Br0wserz/la-nostra-casa-domotica/13592215_1139793016043733_2497820112202641758_n.jpg

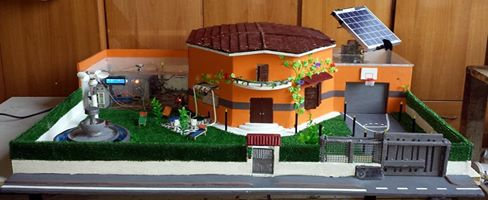
13592215_1139793016043733_2497820112202641758_n.jpg
