Br0wserz/la-nostra-casa-domotica/schemi/controllo-luci-giardino.png

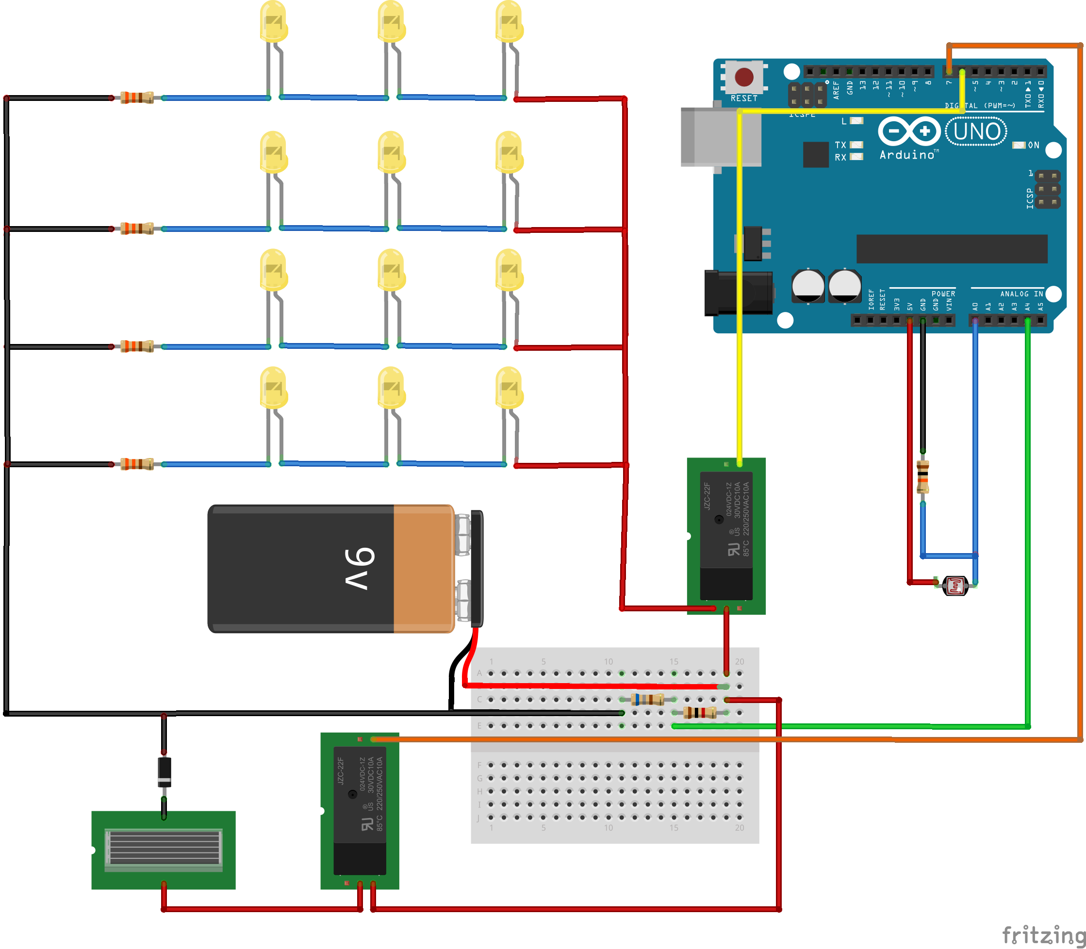
schemi/controllo-luci-giardino.png
