Br0wserz/la-nostra-casa-domotica/schemi/inseguitore_bb.png

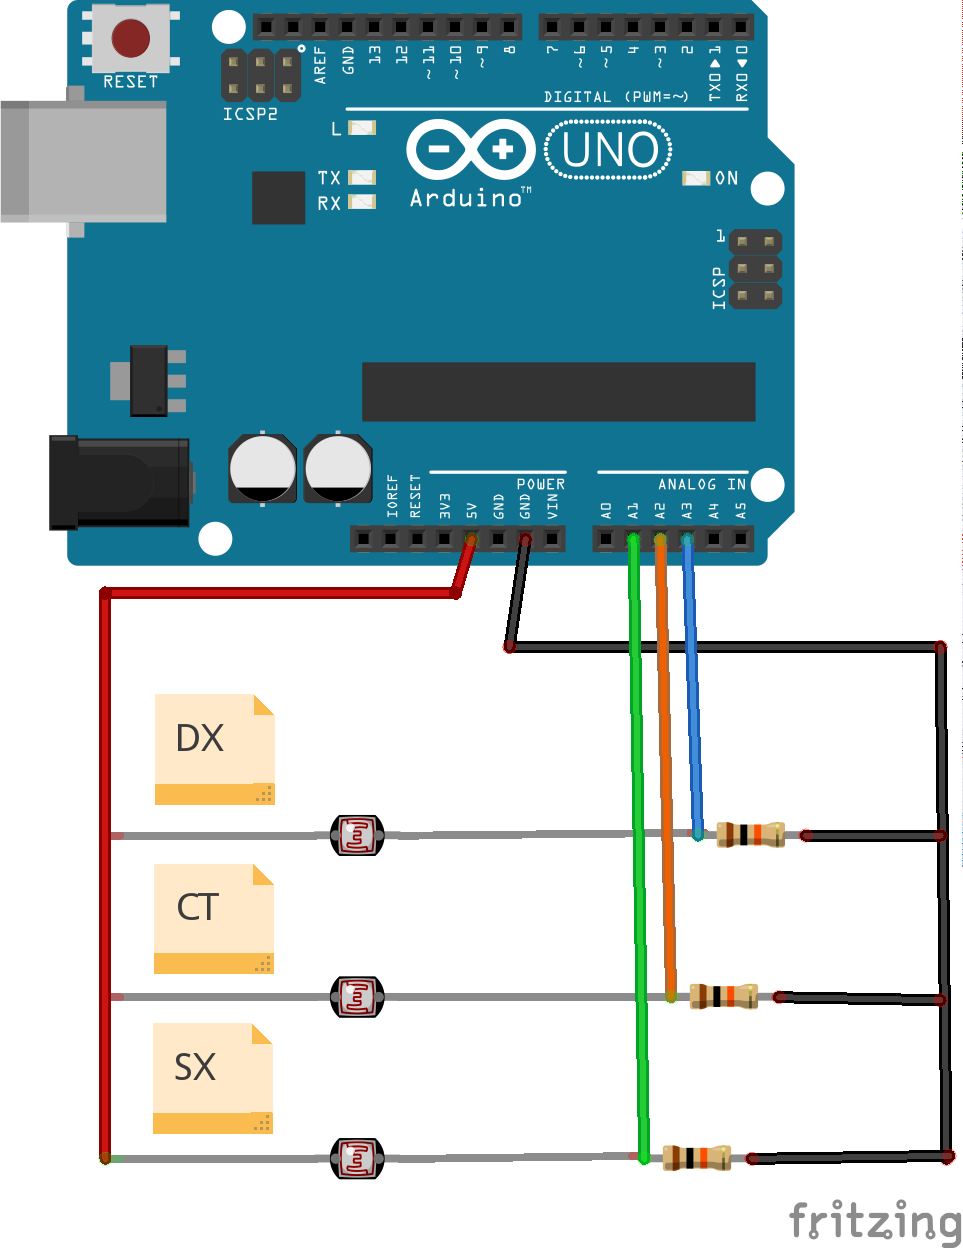
schemi/inseguitore_bb.png
