Br0wserz/la-nostra-casa-domotica/schemi/schema-motori.png

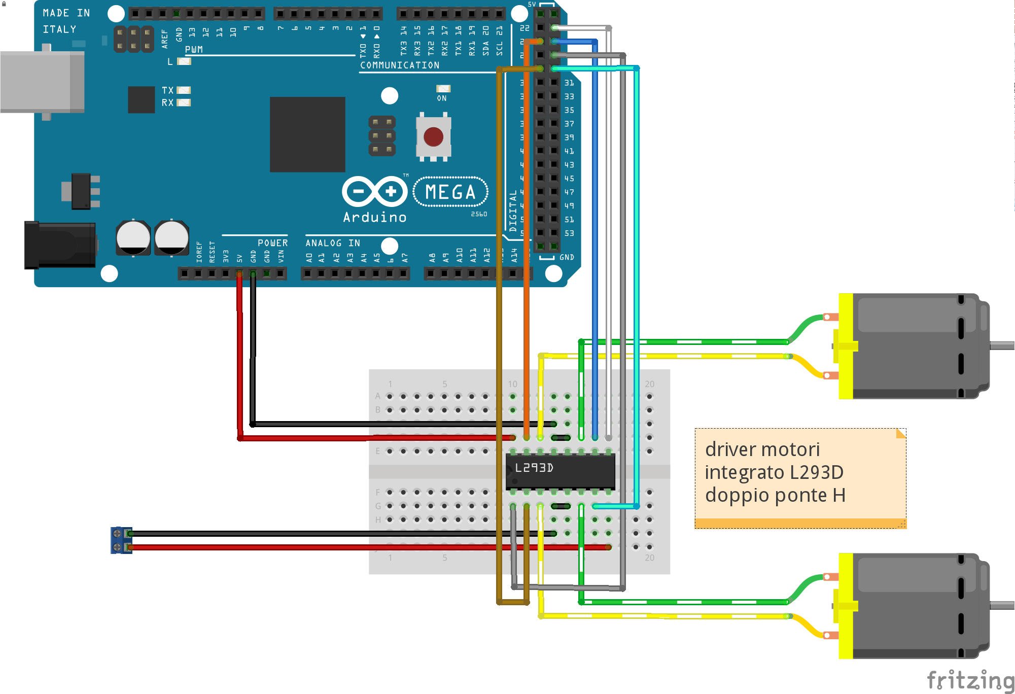
schemi/schema-motori.png
