Br0wserz/la-nostra-casa-domotica/schemi/schema-oscillatori.png

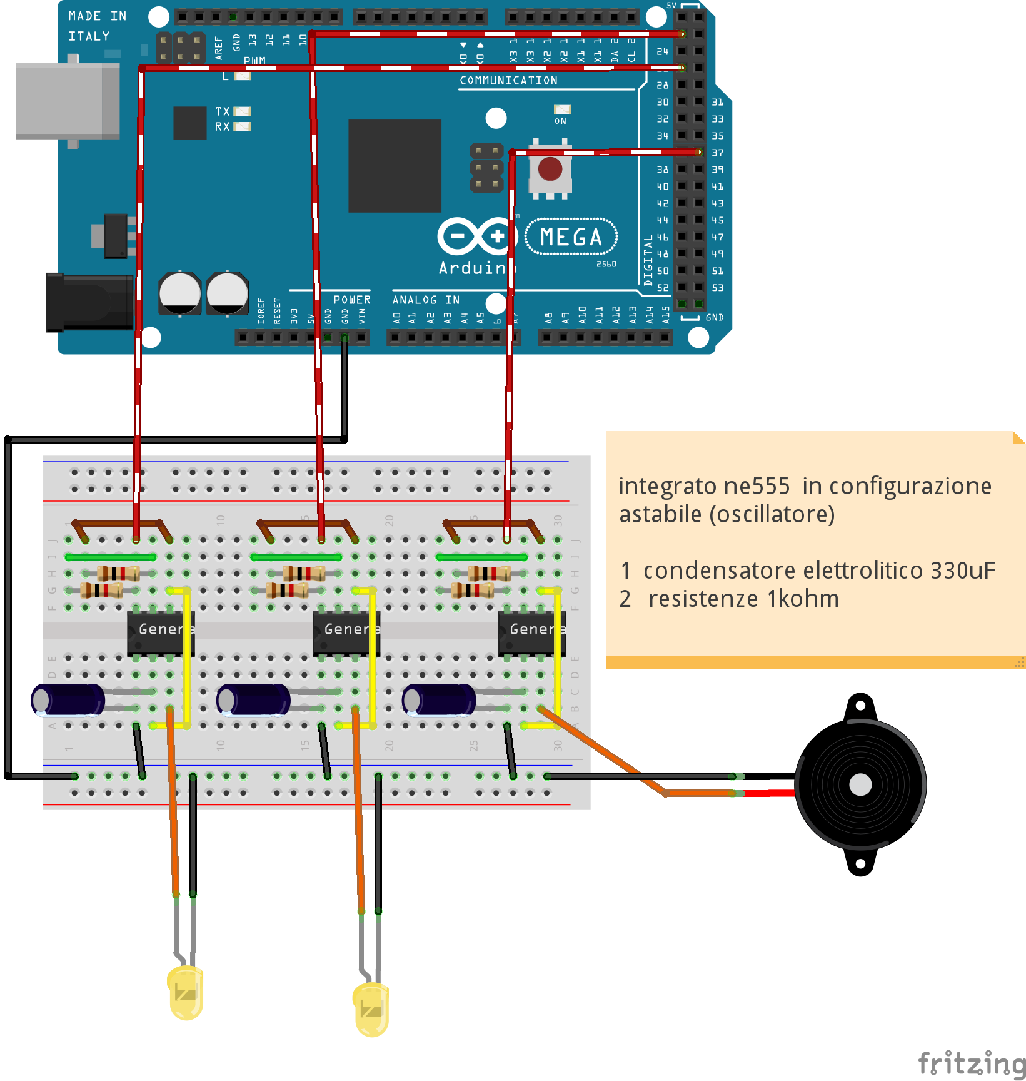
schemi/schema-oscillatori.png
