Br0wserz/la-nostra-casa-domotica/source code/uno/header.h

#ifndef _HEADER_H_
#define _HEADER_H_

#define 	RL_ON			LOW
#define 	RL_OFF			HIGH

#define 	LDR				A0
#define 	LDR_SX			A1
#define 	LDR_DX			A2
#define 	LDR_CT			A3
#define		BAT_LV			A4

#define 	GAR_LED			13
#define 	LG_GAR			 4
#define		BATTERY			 7

#define 	FNC_GAR_DW 		 0
#define 	FNC_GAR_UP 		 1

#define		ONE_MINUTE		60000

#endif
